Uvin99/UV_Disinfector/README.md

# UV-C Disinfector
This project was done as a partial fulfillment of the module  EN3023 Electronic Design Realization

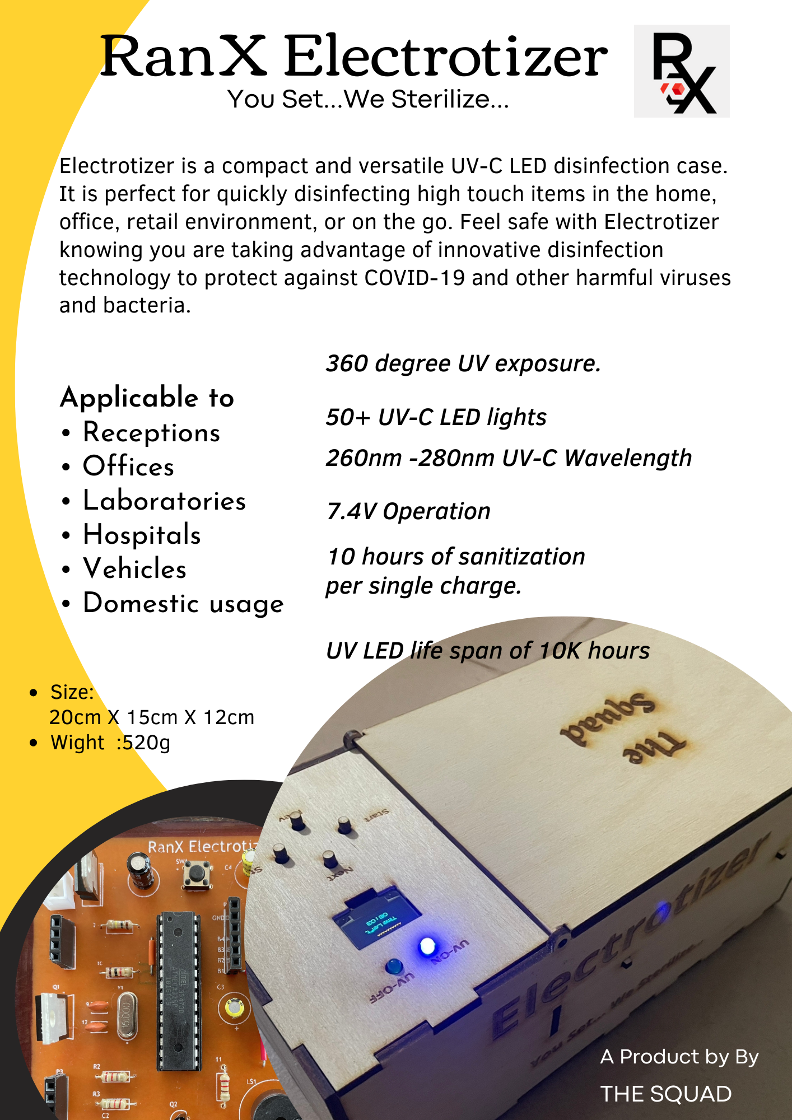
[picture p1: Project details/RanX Electrotizer.png]
