Uvin99/UV_Disinfector/Enclosure/Solidworks/1.png

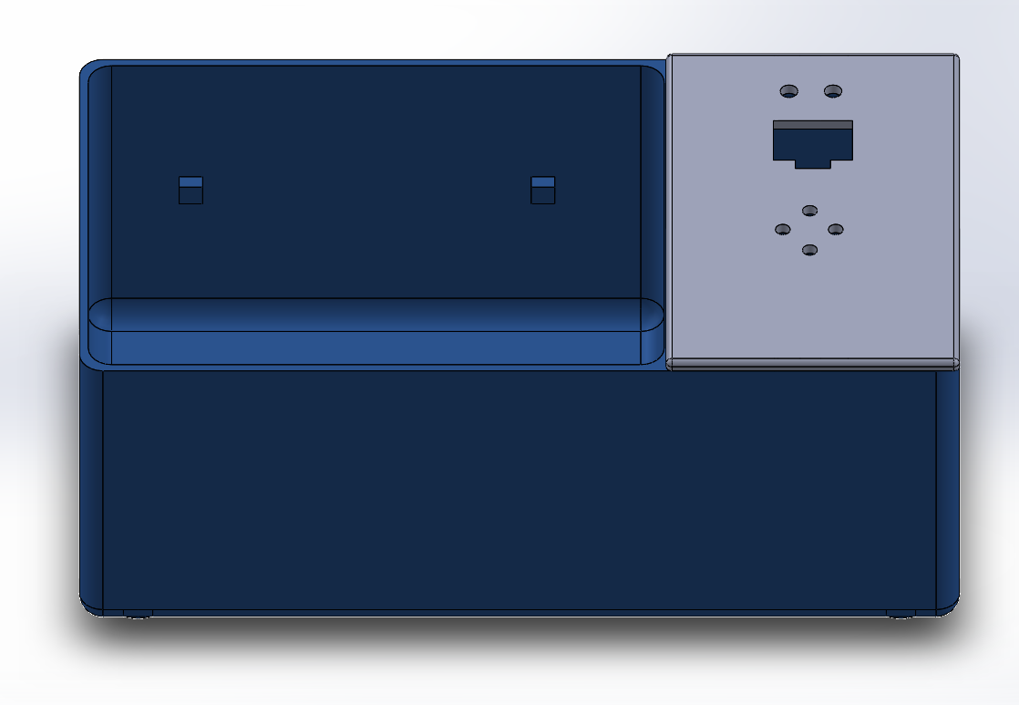
Enclosure/Solidworks/1.png
