Uvin99/UV_Disinfector/Enclosure/Solidworks/2.png

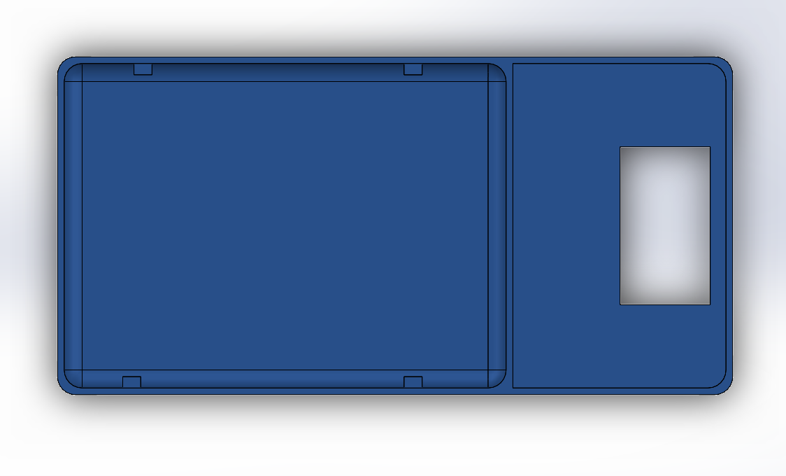
Enclosure/Solidworks/2.png
