Uvin99/UV_Disinfector/Enclosure/Solidworks/3.png

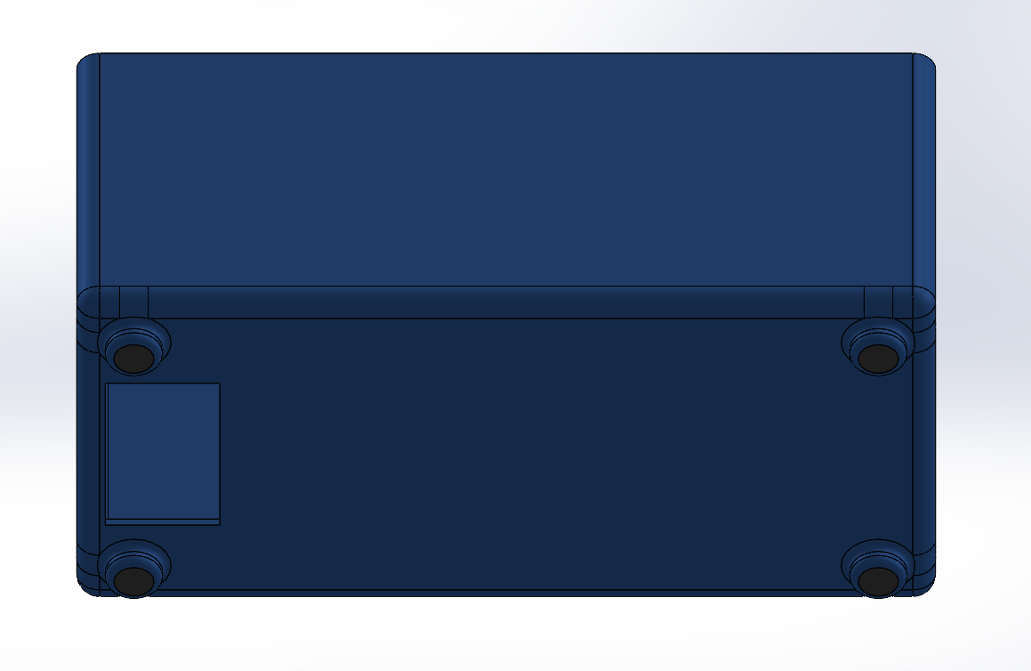
Enclosure/Solidworks/3.png
