Uvin99/UV_Disinfector/Enclosure/Solidworks/4.png

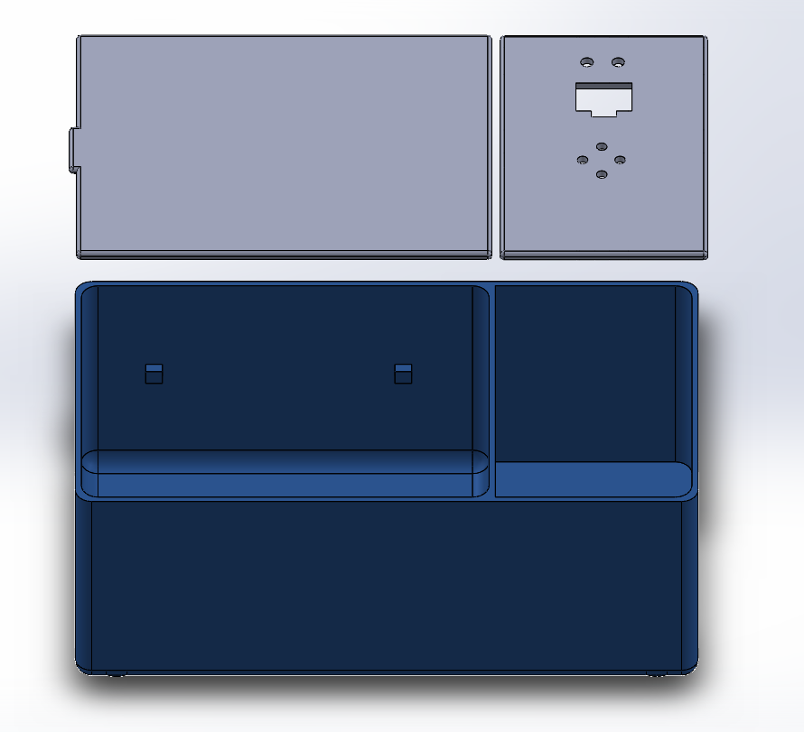
Enclosure/Solidworks/4.png
