Uvin99/UV_Disinfector/Enclosure/Solidworks/5.png

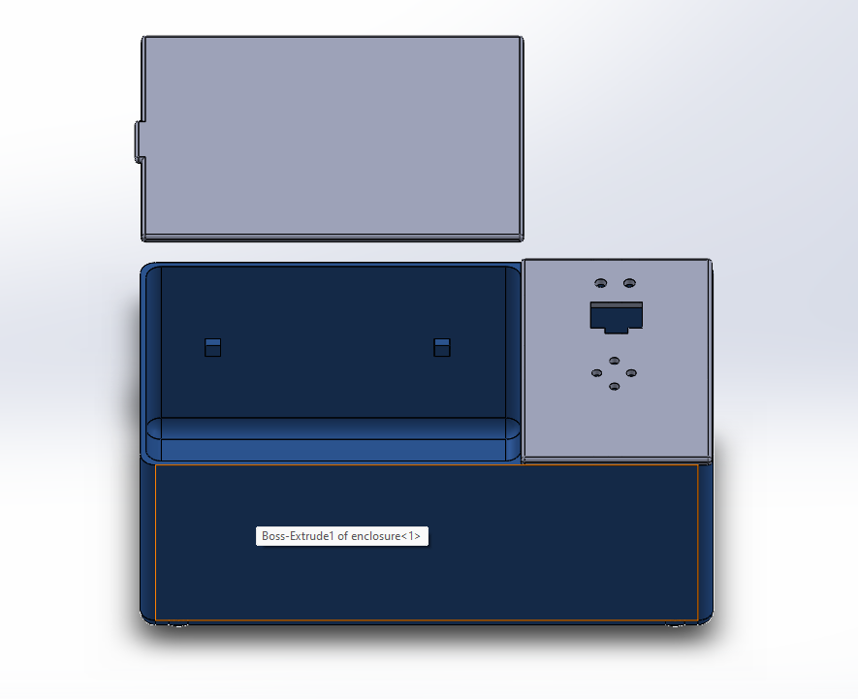
Enclosure/Solidworks/5.png
