Uvin99/UV_Disinfector/Enclosure/Solidworks/6.png

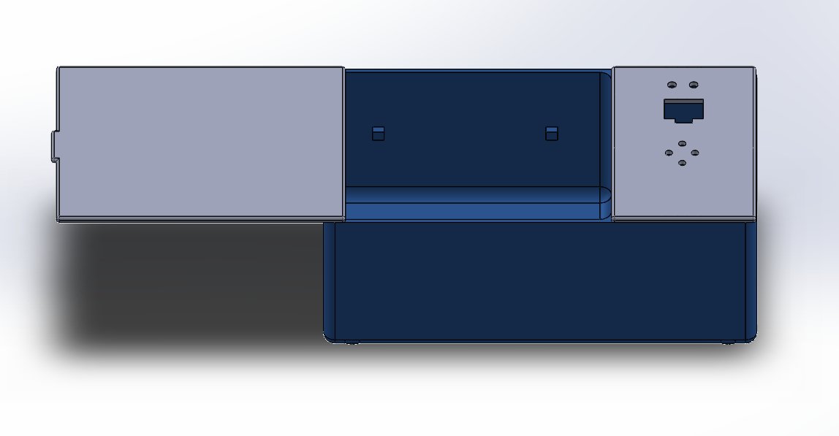
Enclosure/Solidworks/6.png
