Uvin99/UV_Disinfector/Enclosure/Solidworks/7.png

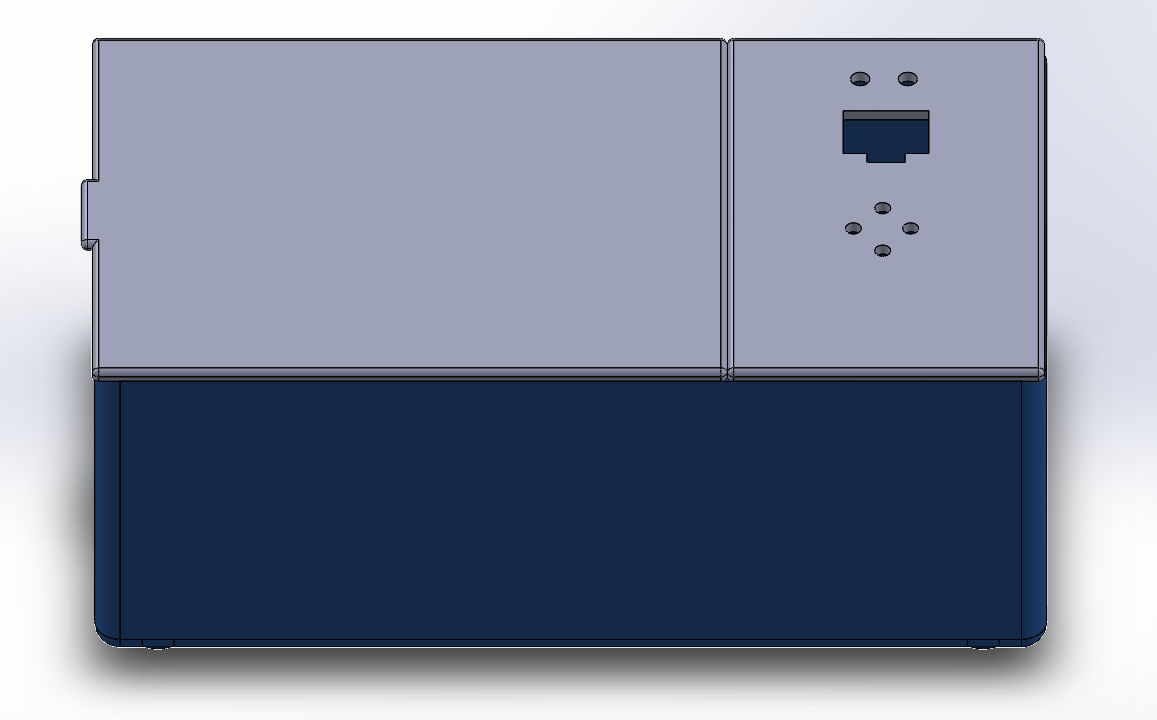
Enclosure/Solidworks/7.png
