Uvin99/UV_Disinfector/Enclosure/Solidworks/Ass01.SLDASM

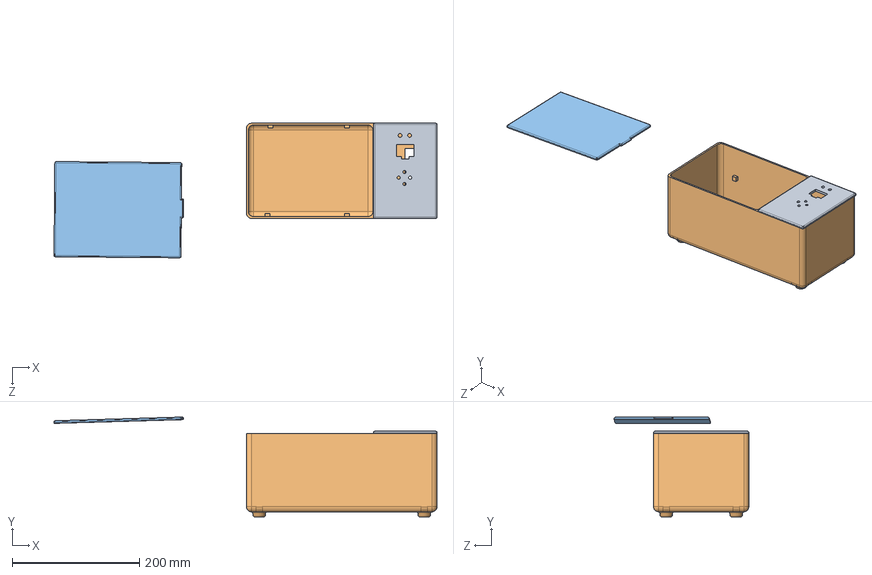
[picture p36: CAD file, 2023-01-24]
Enclosure/Solidworks/Ass01.SLDASM
603.0 x 157.1 x 212.0 mm
displaypart
enclosure
top slider
