Uvin99/UV_Disinfector/Enclosure/Solidworks/Ass02.SLDASM

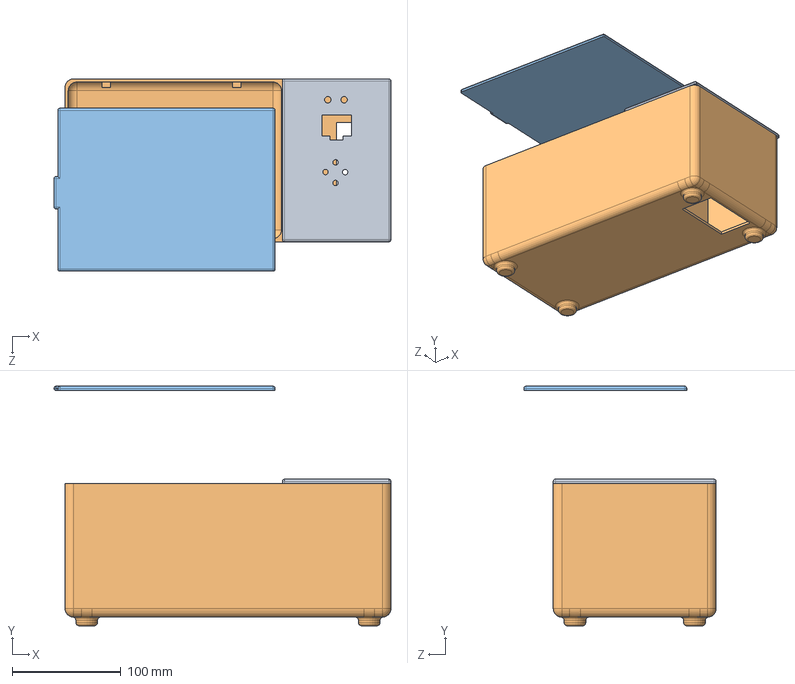
[picture p37: CAD file, 2023-01-24]
Enclosure/Solidworks/Ass02.SLDASM
310.1 x 220.6 x 177.0 mm
displaypart
enclosure
top slider
