Uvin99/UV_Disinfector/Enclosure/Solidworks/Ass03.SLDASM

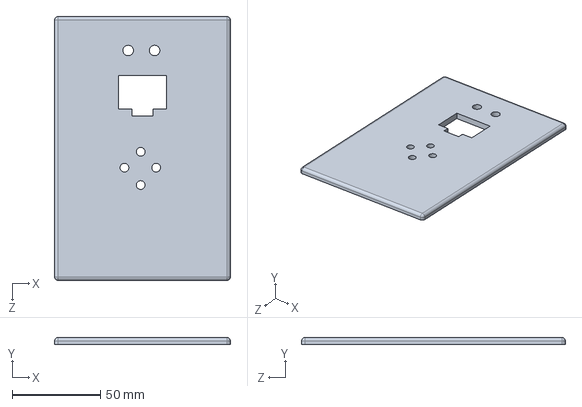
[picture p38: CAD file, 2023-01-24]
Enclosure/Solidworks/Ass03.SLDASM
100.0 x 4.00 x 150.0 mm
