Uvin99/UV_Disinfector/Enclosure/Solidworks/Assembly Final.SLDASM

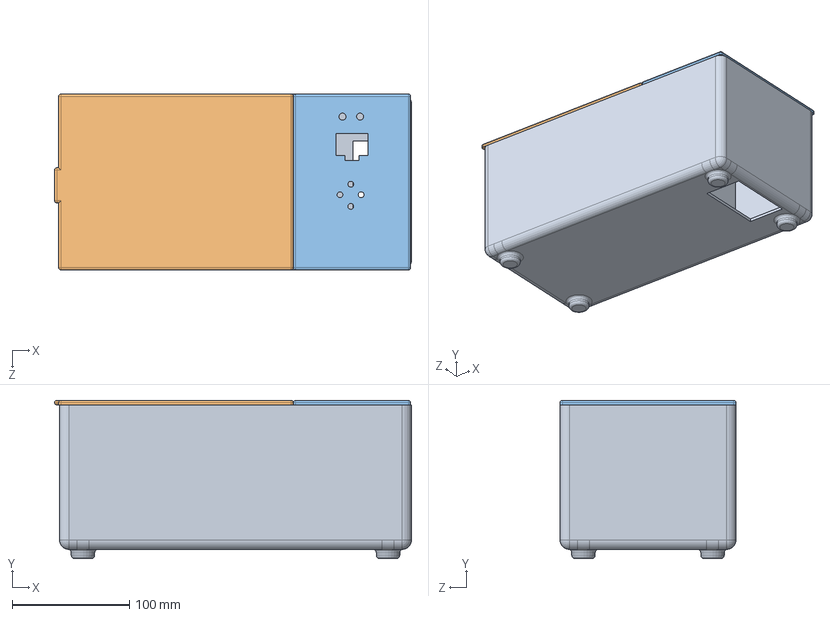
[picture p39: CAD file, 2023-01-24]
Enclosure/Solidworks/Assembly Final.SLDASM
304.3 x 135.0 x 150.0 mm
enclosure
top slider
displaypart
