Uvin99/UV_Disinfector/PCB/UV_disinfector/PCB1.step

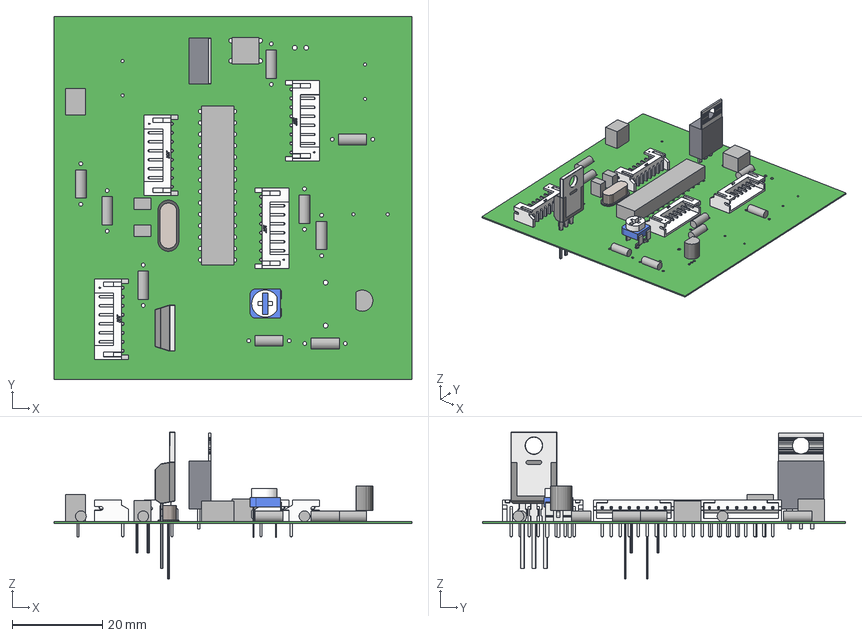
[picture p40: CAD file, 2023-01-24]
PCB/UV_disinfector/PCB1.step
79.5 x 80.6 x 32.6 mm
Extruded x 57
Pot_-_RES_VAR1
Pieza55
Pieza56
terminal x 4
logo x 4
