Uvin99/UV_Disinfector/PCB/UV_disinfector/Button_PCB.step

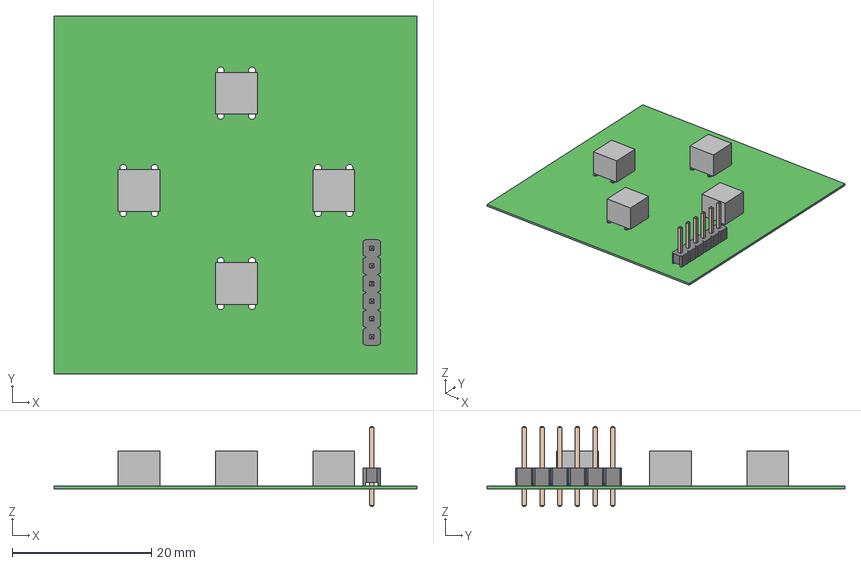
[picture p41: CAD file, 2023-01-24]
PCB/UV_disinfector/Button_PCB.step
52.1 x 51.3 x 11.5 mm
Extruded x 4
6130xx11121_PIN x 6
