Uvin99/UV_Disinfector/Enclosure/Solidworks/top slider.SLDPRT

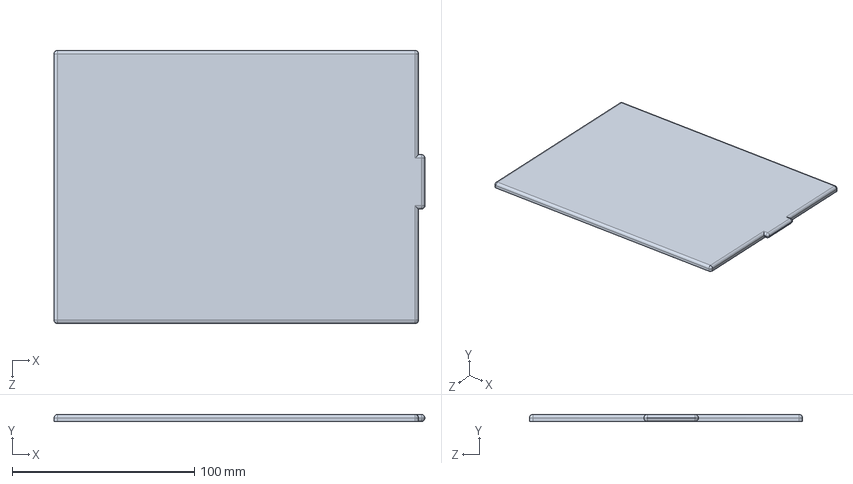
[picture p42: CAD file, 2023-01-24]
Enclosure/Solidworks/top slider.SLDPRT
203.5 x 4.00 x 150.0 mm
