Uvin99/UV_Disinfector/(list of files, cad)

Other CAD files:
Enclosure/Solidworks/displaypart.SLDPRT
