Uvin99/UV_Disinfector/Testing/IMG_5729.JPG

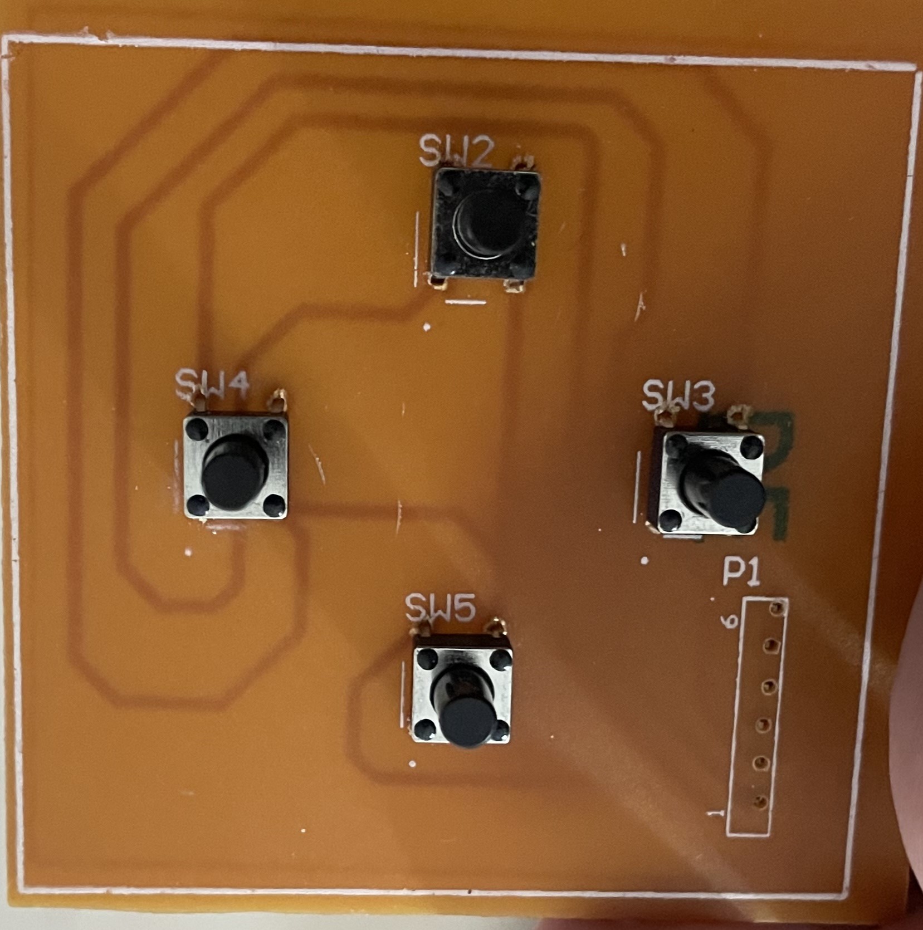
Testing/IMG_5729.JPG
