Uvin99/UV_Disinfector/Testing/IMG_5753.JPG

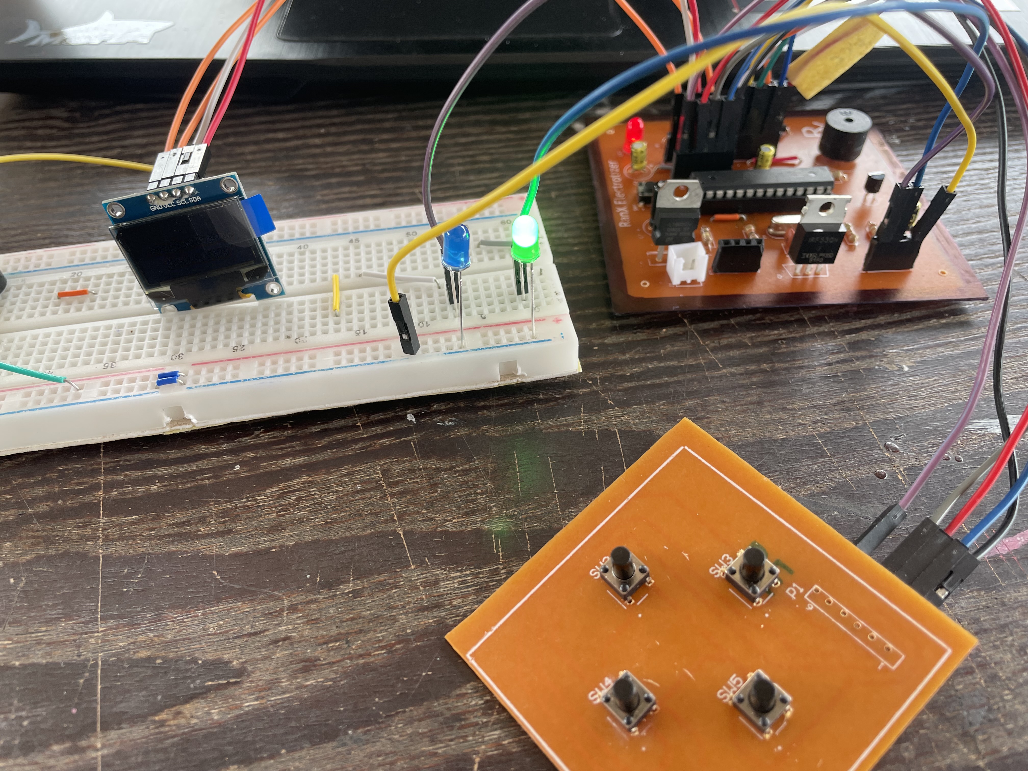
Testing/IMG_5753.JPG
