Uvin99/UV_Disinfector/Testing/IMG_5783.JPG

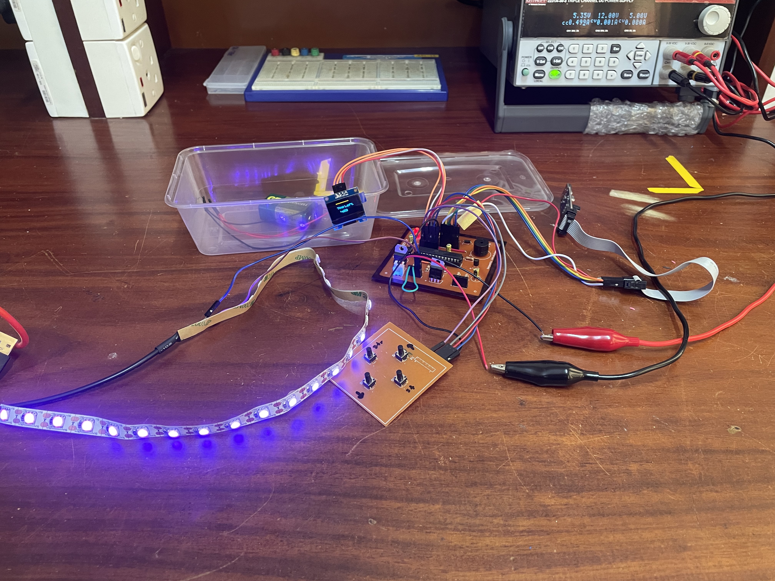
Testing/IMG_5783.JPG
