Uvin99/UV_Disinfector/Testing/IMG_5784.JPG

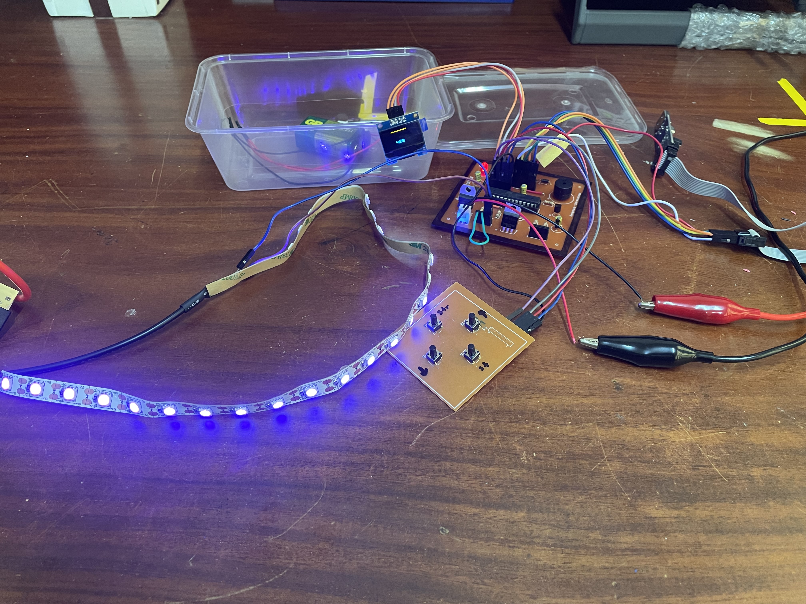
Testing/IMG_5784.JPG
