Uvin99/UV_Disinfector/Testing/WhatsApp Image 2023-01-20 at 7.02.08 PM.jpeg

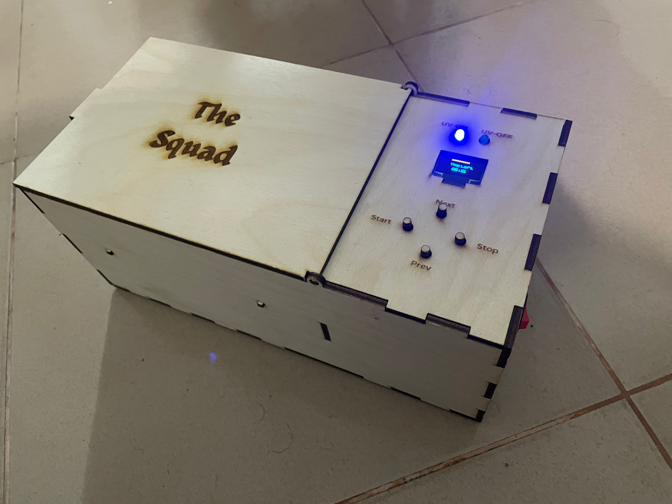
Testing/WhatsApp Image 2023-01-20 at 7.02.08 PM.jpeg
