Uvin99/UV_Disinfector/Enclosure/Illustrator/lacer cutting.pdf

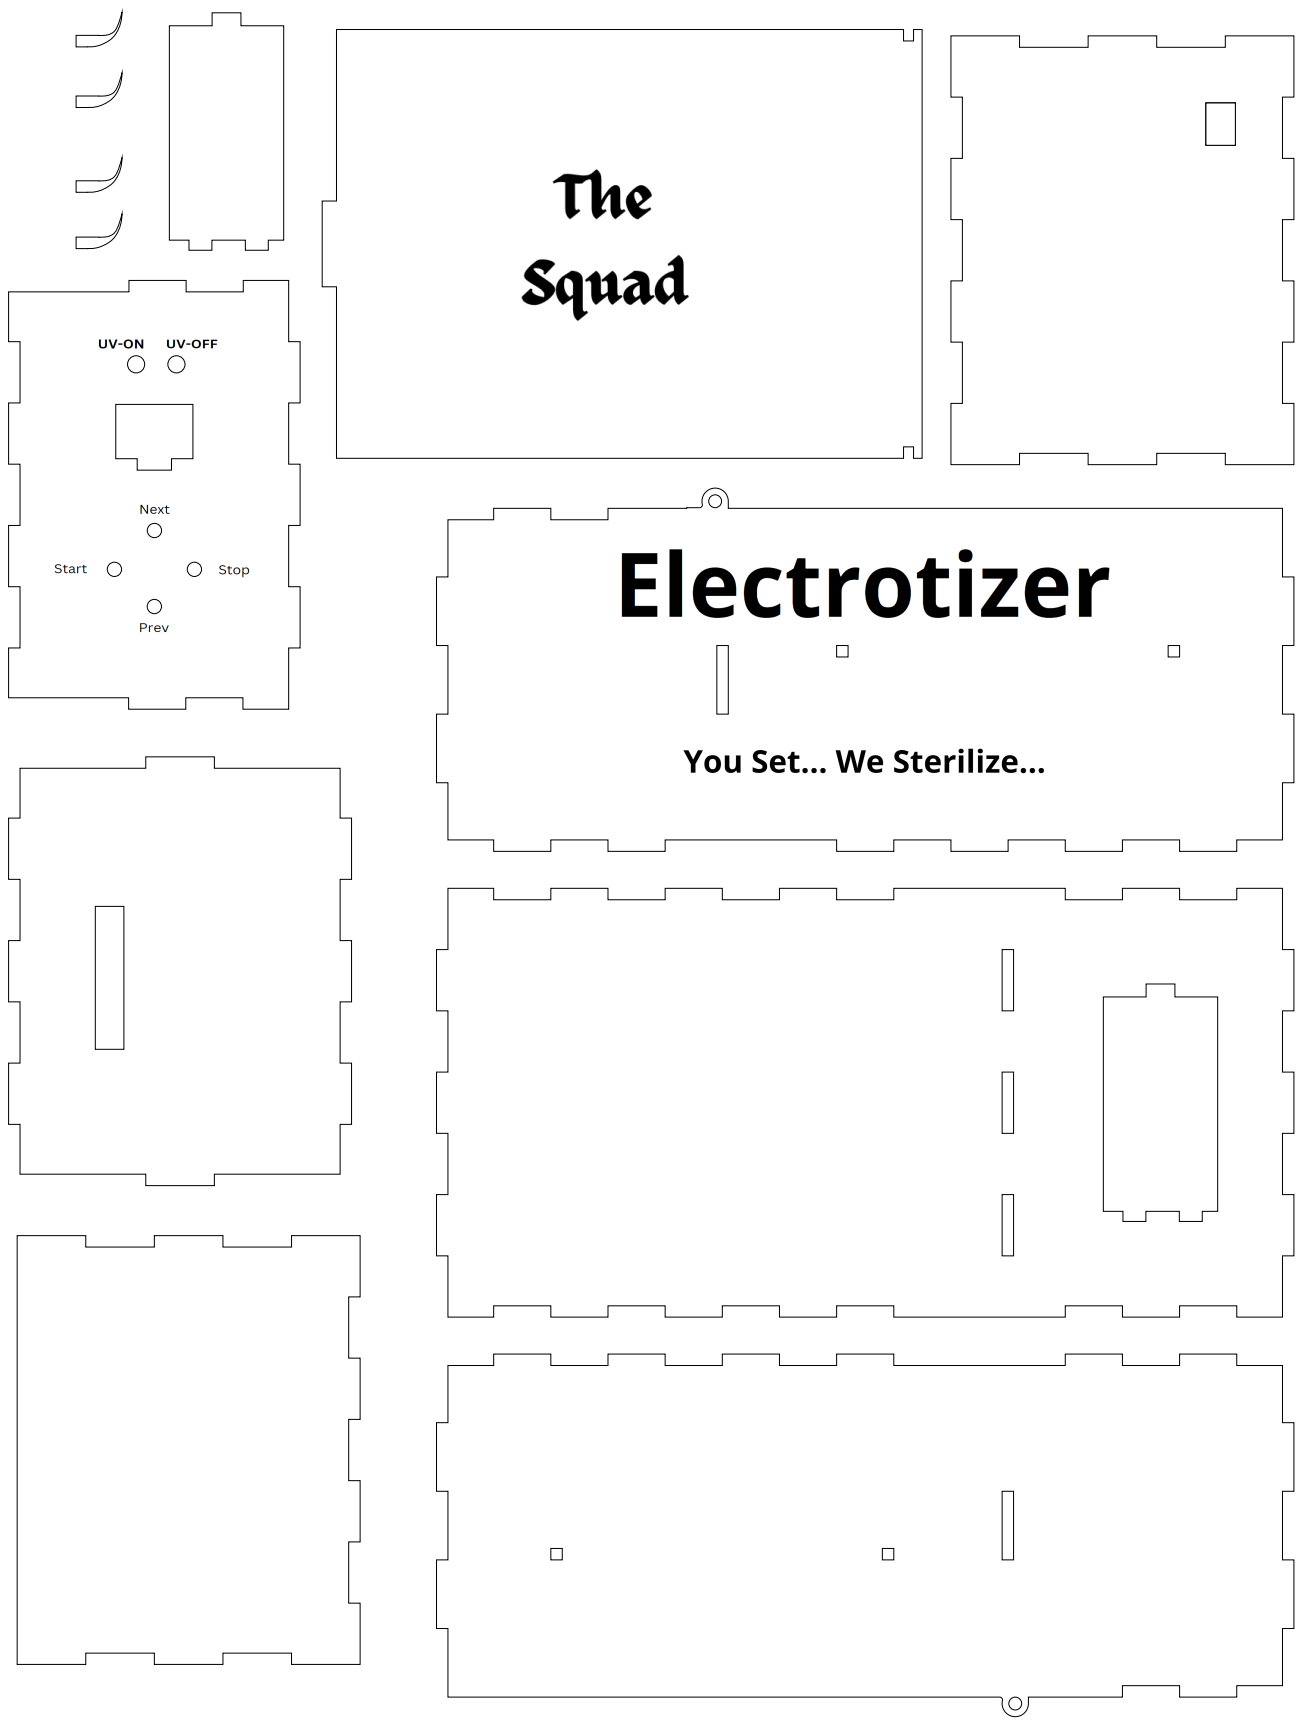
[picture p53: page 1]
