Uvin99/UV_Disinfector/(list of files, drawings)

Other design files:
PCB/PCB_updated version/Button_PCB.PcbDoc
PCB/PCB_updated version/PCB1.PcbDoc
PCB/PCB_updated version/UV_disinfector.PrjPcb
PCB/PCB_updated version/UV_Sheet1.SchDoc
PCB/UV_disinfector/Button_PCB.PcbDoc
PCB/UV_disinfector/PCB1.PcbDoc
PCB/UV_disinfector/UV_disinfector.PrjPcb
PCB/UV_disinfector/UV_Sheet1.SchDoc
Simulation/COVID_Disinfector.pdsprj
Simulation/Project Backups/COVID_Disinfector [20221107, 11-54-06].pdsprj
Simulation/Project Backups/COVID_Disinfector [20221107, 12-52-02].pdsprj
Simulation/Project Backups/COVID_Disinfector [20221107, 12-53-40].pdsprj
Simulation/Simulation_updated/Project Backups/Covid [20221111, 14-08-06].pdsprj
Simulation/Simulation_updated/Project Backups/Covid [20221111, 18-01-16].pdsprj
Simulation/Simulation_updated/Project Backups/Covid [20221112, 11-29-36].pdsprj
Simulation/Simulation_updated/Project Backups/Covid [20221112, 12-39-26].pdsprj
Simulation/Simulation_updated/Project Backups/Covid [20221113, 18-54-27].pdsprj
Simulation/Simulation_updated/Project Backups/Covid [20221113, 18-54-29].pdsprj
Simulation/Simulation_updated/Project Backups/Covid [20221115, 14-42-20].pdsprj
Simulation/Simulation_updated/Project Backups/Covid [20221116, 13-07-30].pdsprj
Simulation/Simulation_updated/Project Backups/Covid [20221118, 12-08-13].pdsprj
Simulation/Simulation_updated/Project Backups/UV_Disinfector [20221118, 12-24-06].pdsprj
Simulation/Simulation_updated/UV_Disinfector.pdsprj
