Uvin99/UV_Disinfector/(commit log)

2022-11-07 Initial simulation implementation
    [COVID_Disinfector [20221107, 11-54-06].pdsprj, COVID_Disinfector [20221107, 12-52-02].pdsprj, COVID_Disinfector [20221107, 12-53-40].pdsprj, COVID_Disinfector.pdsprj]
2022-11-18 simulation 2
    [Covid [20221111, 14-08-06].pdsprj, Covid [20221111, 18-01-16].pdsprj, Covid [20221112, 11-29-36].pdsprj, Covid [20221112, 12-39-26].pdsprj, Covid [20221113, 18-54-27].pdsprj, Covid [20221113, 18-54-29].pdsprj, Covid [20221115, 14-42-20].pdsprj, Covid [20221116, 13-07-30].pdsprj]
2023-01-24 Finalizing Docs
    [Ass01.SLDASM, Ass02.SLDASM, Ass03.SLDASM, Assembly Final.SLDASM, Button_PCB.PcbDoc, Button_PCB.step, PCB1.PcbDoc, PCB1.step]
2023-01-24 Complete project
    [Covid [20221111, 14-08-06].pdsprj, Covid [20221111, 18-01-16].pdsprj, Covid [20221112, 11-29-36].pdsprj, Covid [20221112, 12-39-26].pdsprj, Covid [20221113, 18-54-27].pdsprj, Covid [20221113, 18-54-29].pdsprj, Covid [20221115, 14-42-20].pdsprj, Covid [20221116, 13-07-30].pdsprj]
